friendlytofu/diy-dual-cmos-camera/case/printable/CamBuildLid.stl

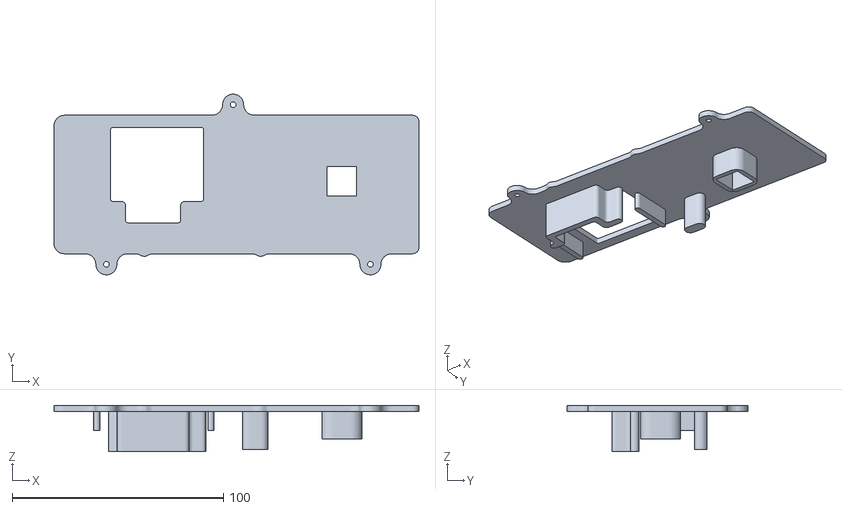
[picture p1: CAD file, 2026-10-28]
case/printable/CamBuildLid.stl
172.8 x 85.5 x 22.0
