friendlytofu/diy-dual-cmos-camera/case/printable/CamBuildFront.stl

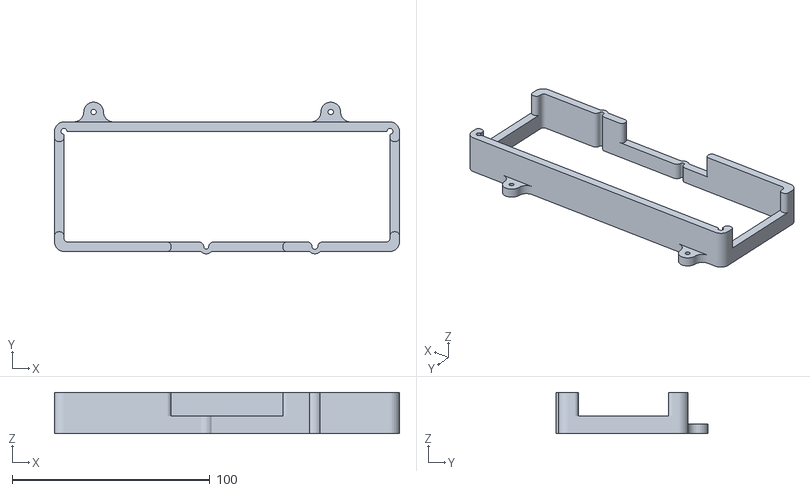
[picture p2: CAD file, 2026-10-28]
case/printable/CamBuildFront.stl
174.6 x 76.7 x 21.0
