friendlytofu/diy-dual-cmos-camera/case/printable/CamBuildCase.stl

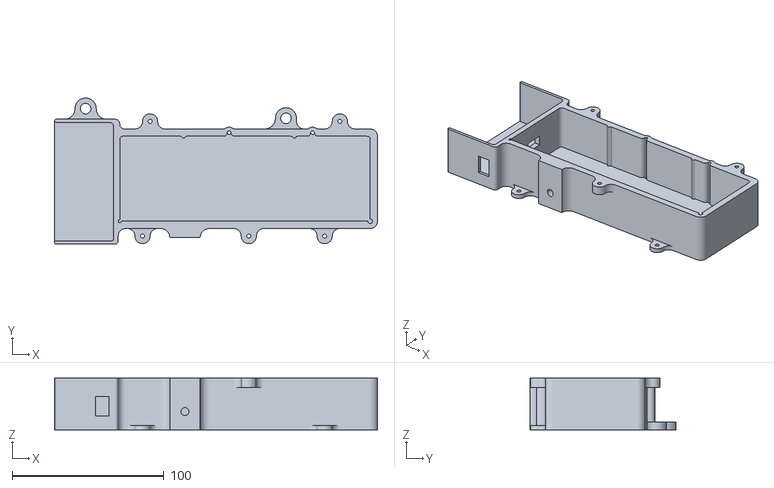
[picture p3: CAD file, 2026-10-28]
case/printable/CamBuildCase.stl
212.8 x 96.2 x 34.0
