friendlytofu/diy-dual-cmos-camera/case/assembly/CamBuild_Assembly_Instructions_Updated.pdf

# CAMERA ENCLOSURE

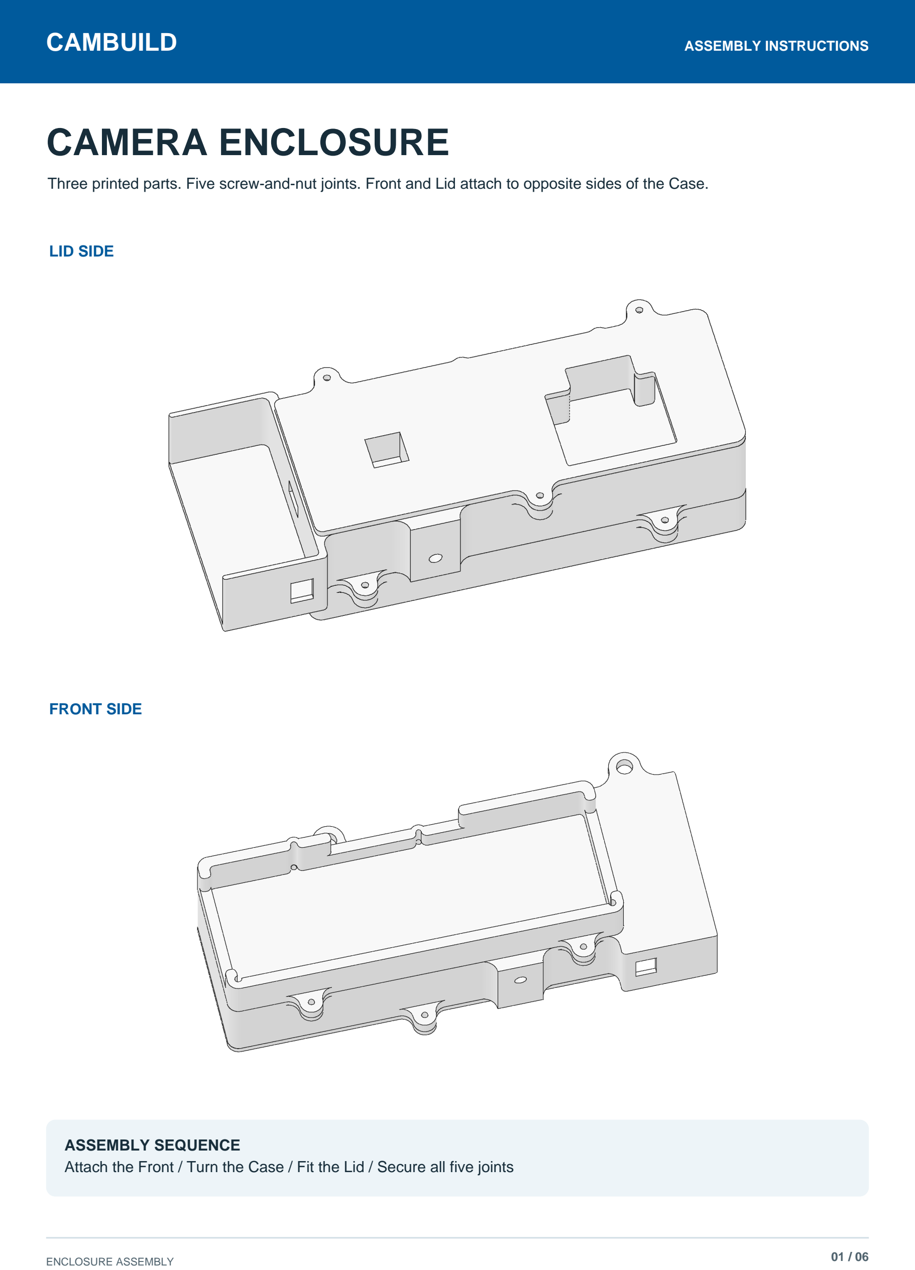
[picture p4: page 1]

CAMBUILD | ASSEMBLY INSTRUCTIONS

Three printed parts. Five screw-and-nut joints. Front and Lid attach to opposite sides of the Case.

ENCLOSURE ASSEMBLY | 01 / 06

LID SIDE

FRONT SIDE

ASSEMBLY SEQUENCE
Attach the Front / Turn the Case / Fit the Lid / Secure all five joints

CAMBUILD | PARTS AND PREPARATION

# CHECK THE PARTS

A = Case body | B = Front frame | C = Lid

A CASE BODY x 1

Case geometry
| 212.8 x 96.2 x 34 mm Main floor: 3 mm Extension floor: 3.4 mm Two lower Front ears Three upper Lid ears Two auxiliary mounting tabs

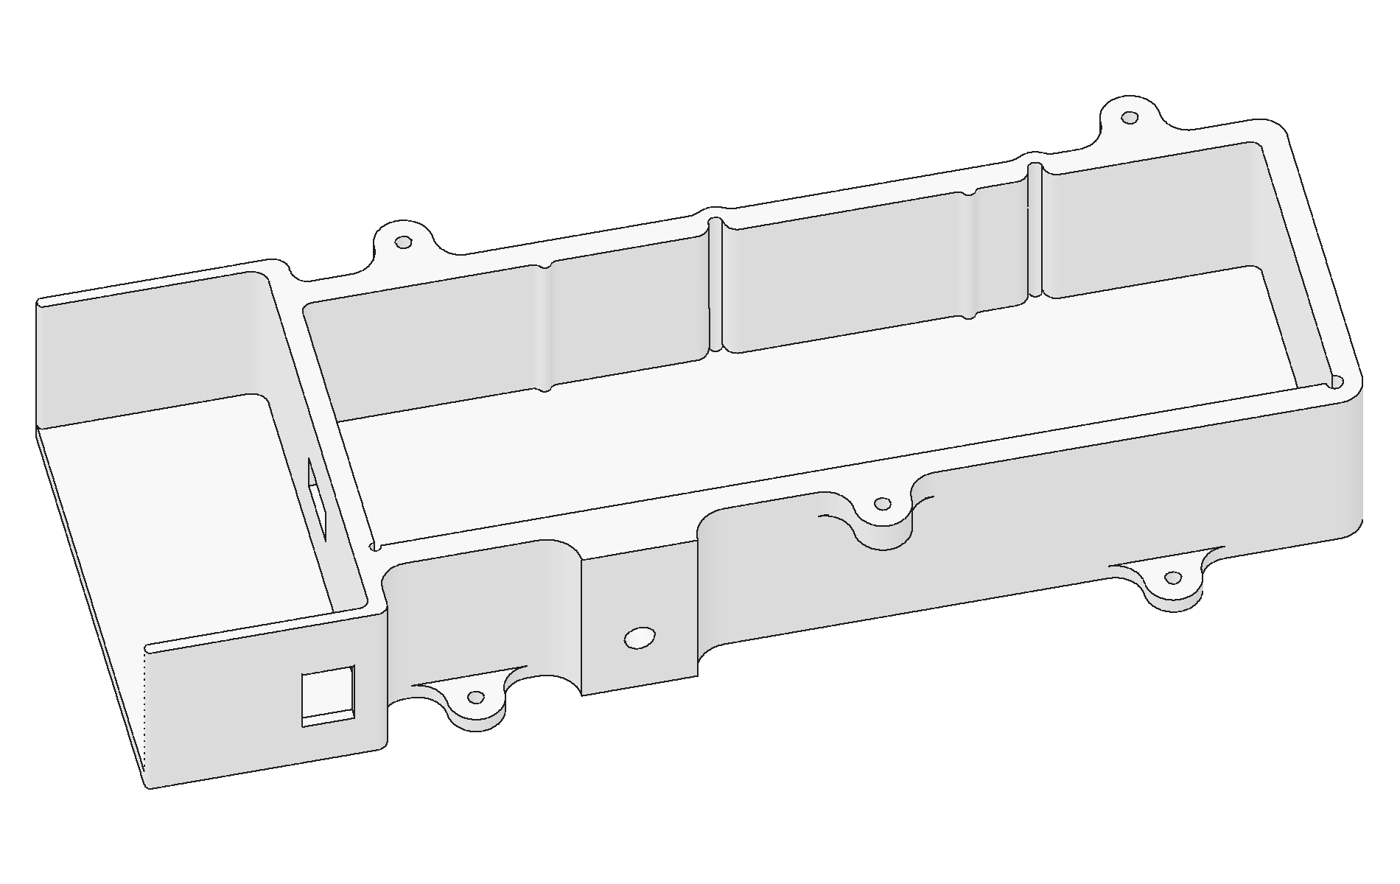
[picture p5: figure]

B FRONT x 1 | C LID x 1

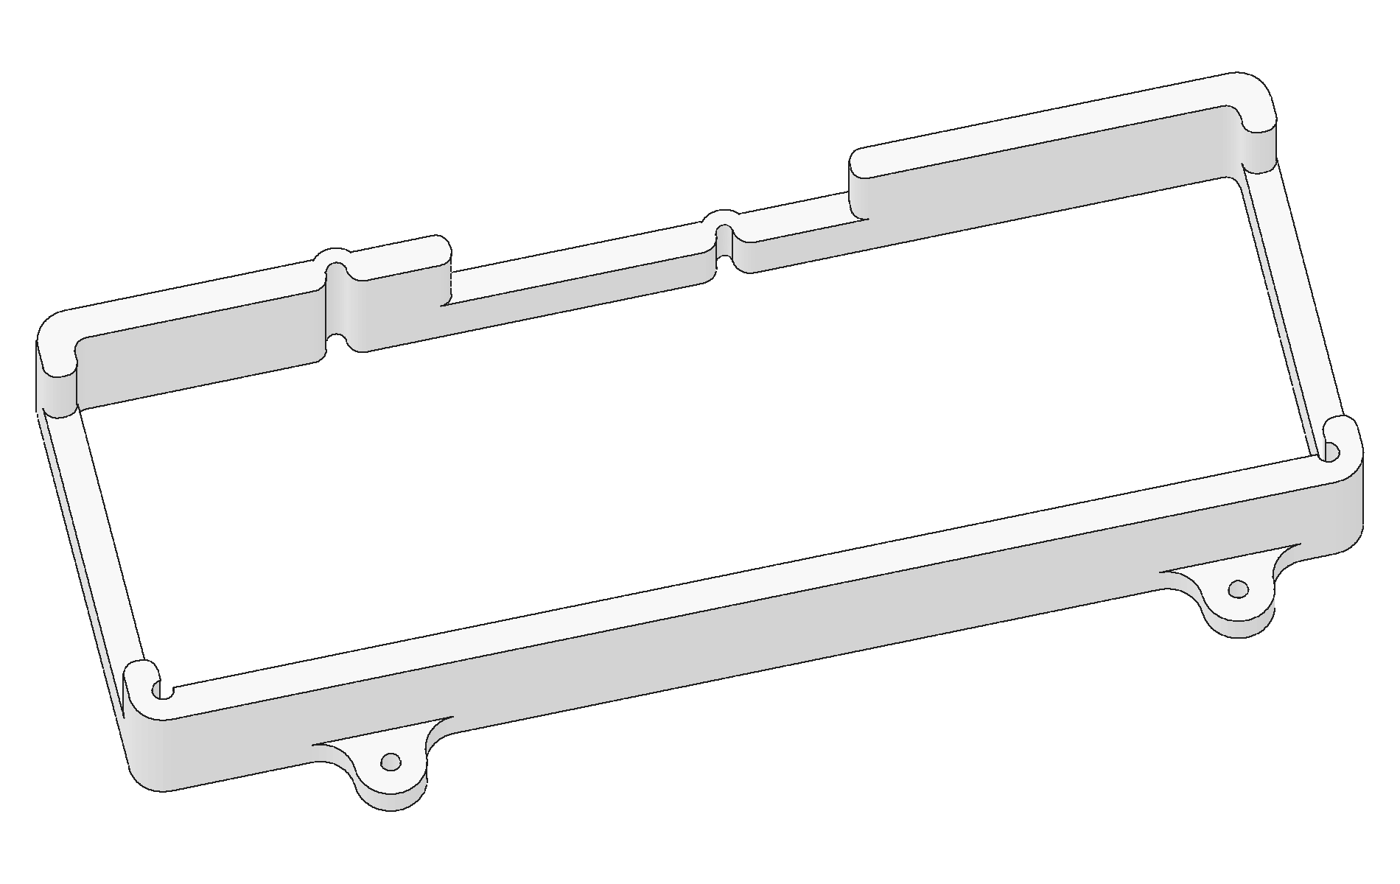
[picture p6: figure]

HARDWARE

M3 screws x 5
M3 nuts x 5

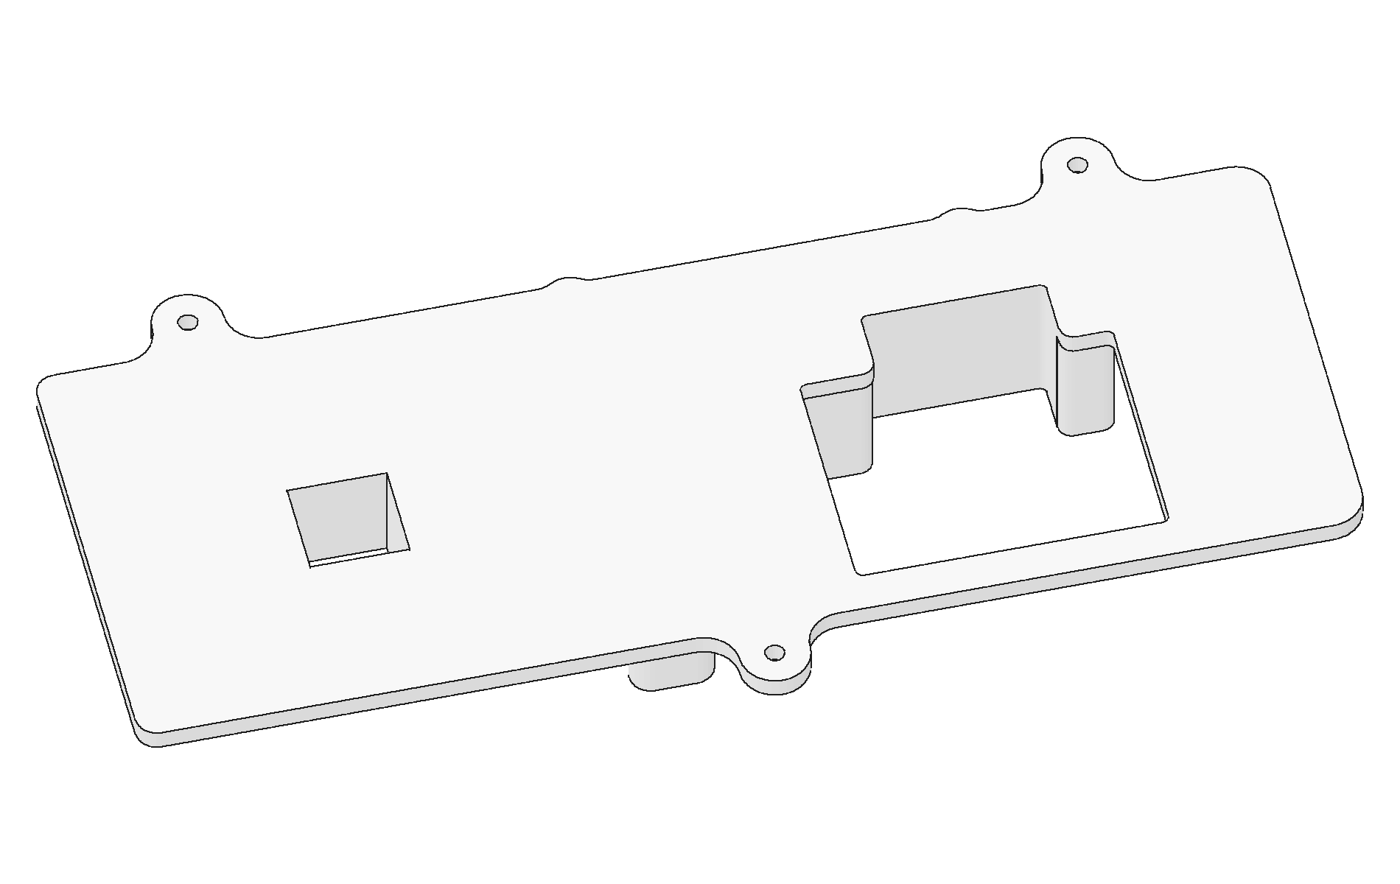
[picture p7: figure]

F1-F2: Front joints, 8 mm plastic stack.
L1-L3: Lid joints, 9 mm plastic stack.
Allow additional screw length for nut engagement.

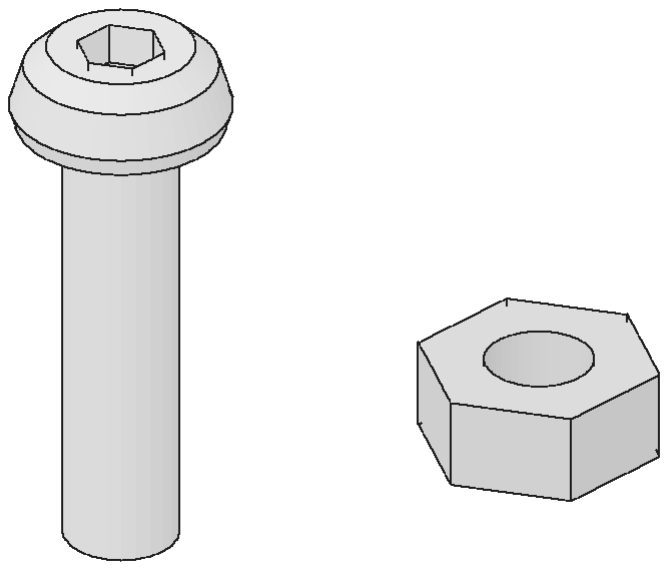
[picture p8: figure]

Remove support material and brim. Deburr the openings and clean the mating surfaces before assembly.

# 1 ATTACH THE FRONT

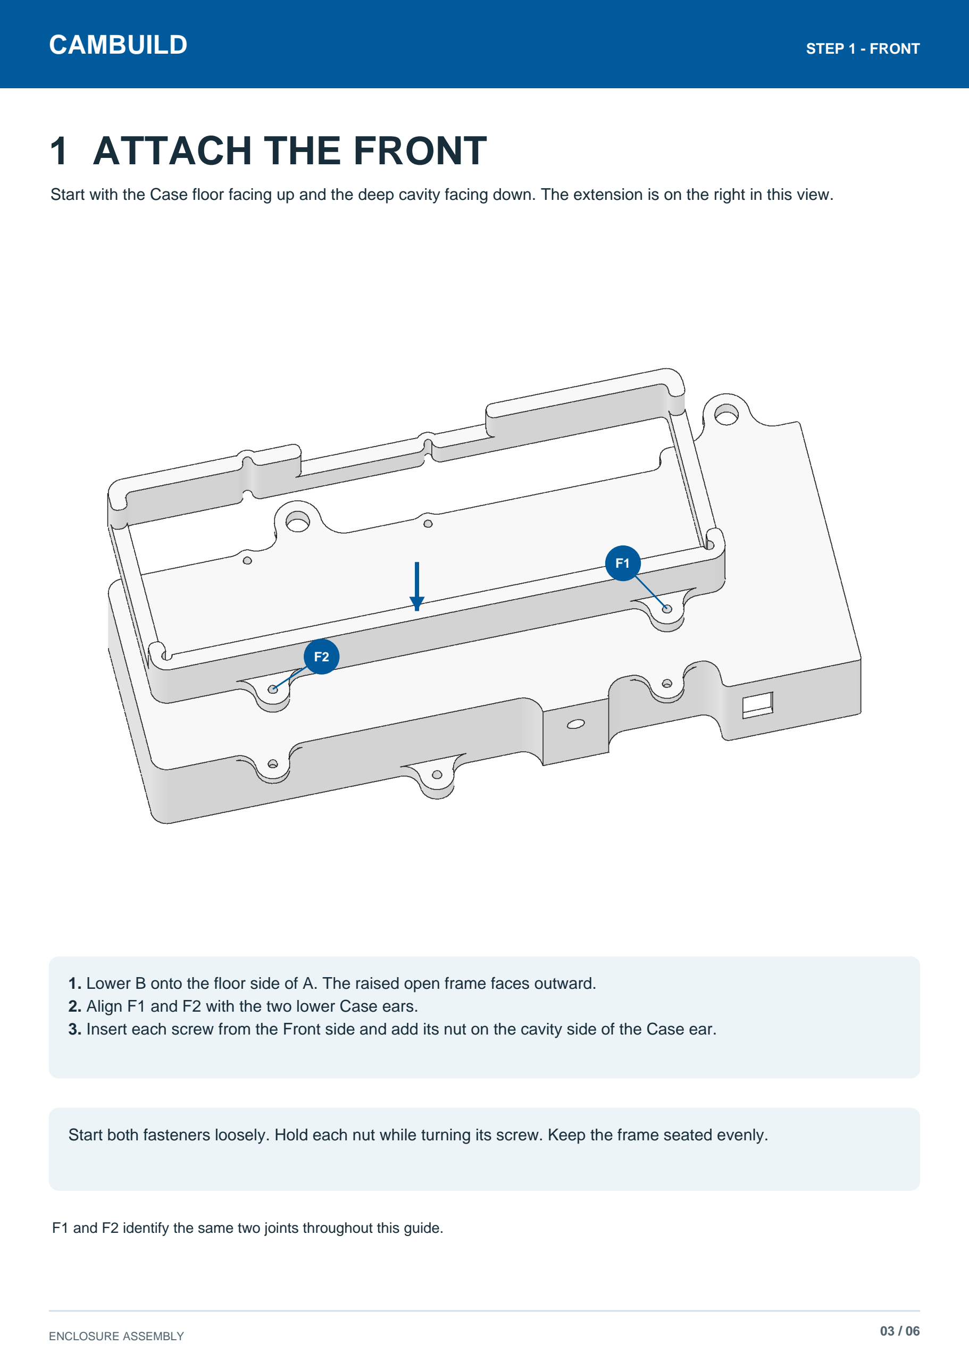
[picture p9: page 3]

CAMBUILD | STEP 1 - FRONT

Start with the Case floor facing up and the deep cavity facing down. The extension is on the right in this view.

F1

F2

1. Lower B onto the floor side of A. The raised open frame faces outward.
2. Align F1 and F2 with the two lower Case ears.
3. Insert each screw from the Front side and add its nut on the cavity side of the Case ear.

Start both fasteners loosely. Hold each nut while turning its screw. Keep the frame seated evenly.

F1 and F2 identify the same two joints throughout this guide.

CAMBUILD | STEP 2 - TURN AND CHECK

# 2 CHECK, THEN TURN

Support both parts while turning the enclosure over. Keep the Front attached loosely.

BEFORE: FLOOR SIDE UP | AFTER: CAVITY SIDE UP

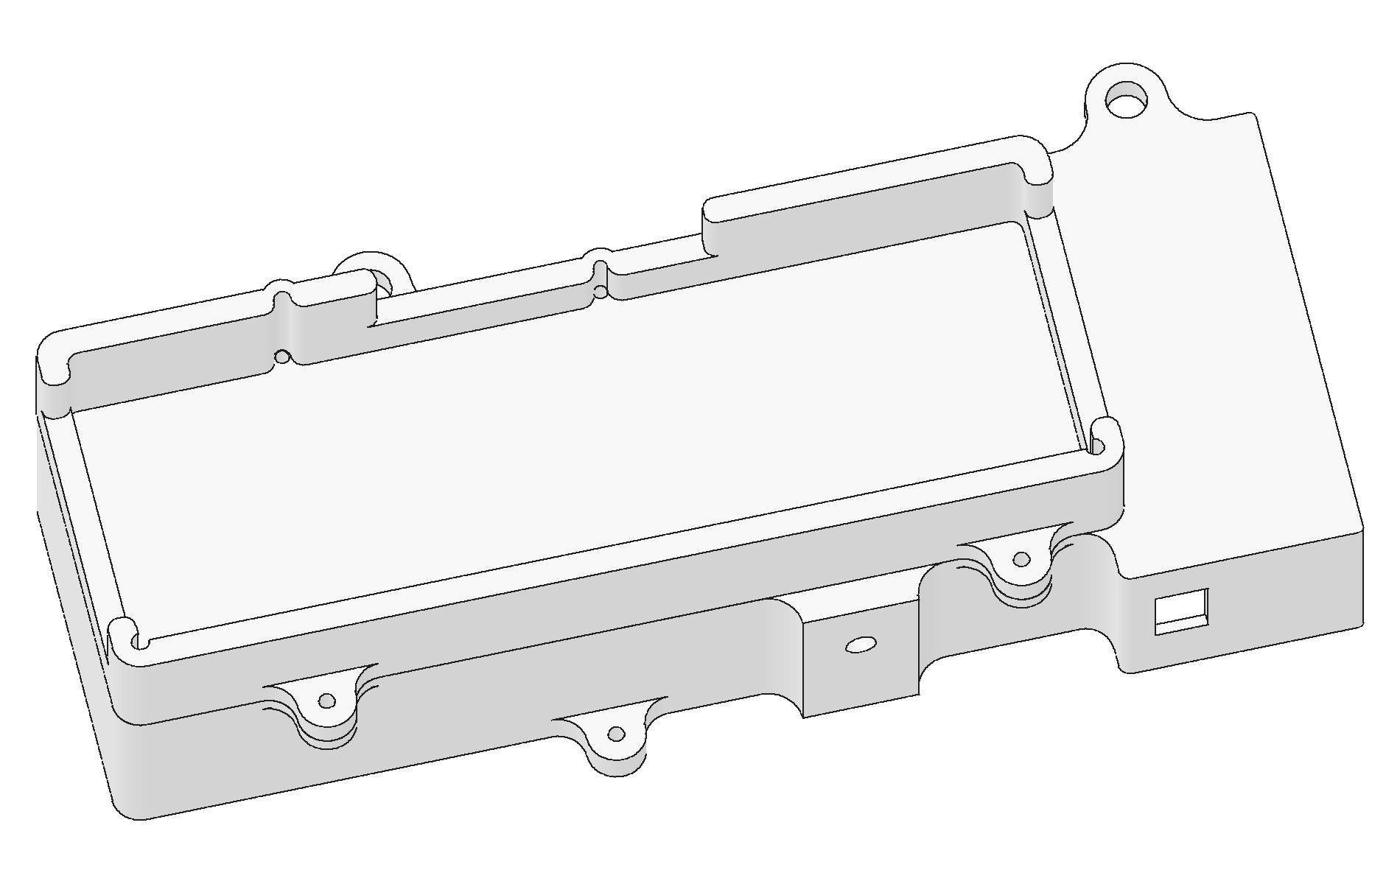
[picture p10: figure]
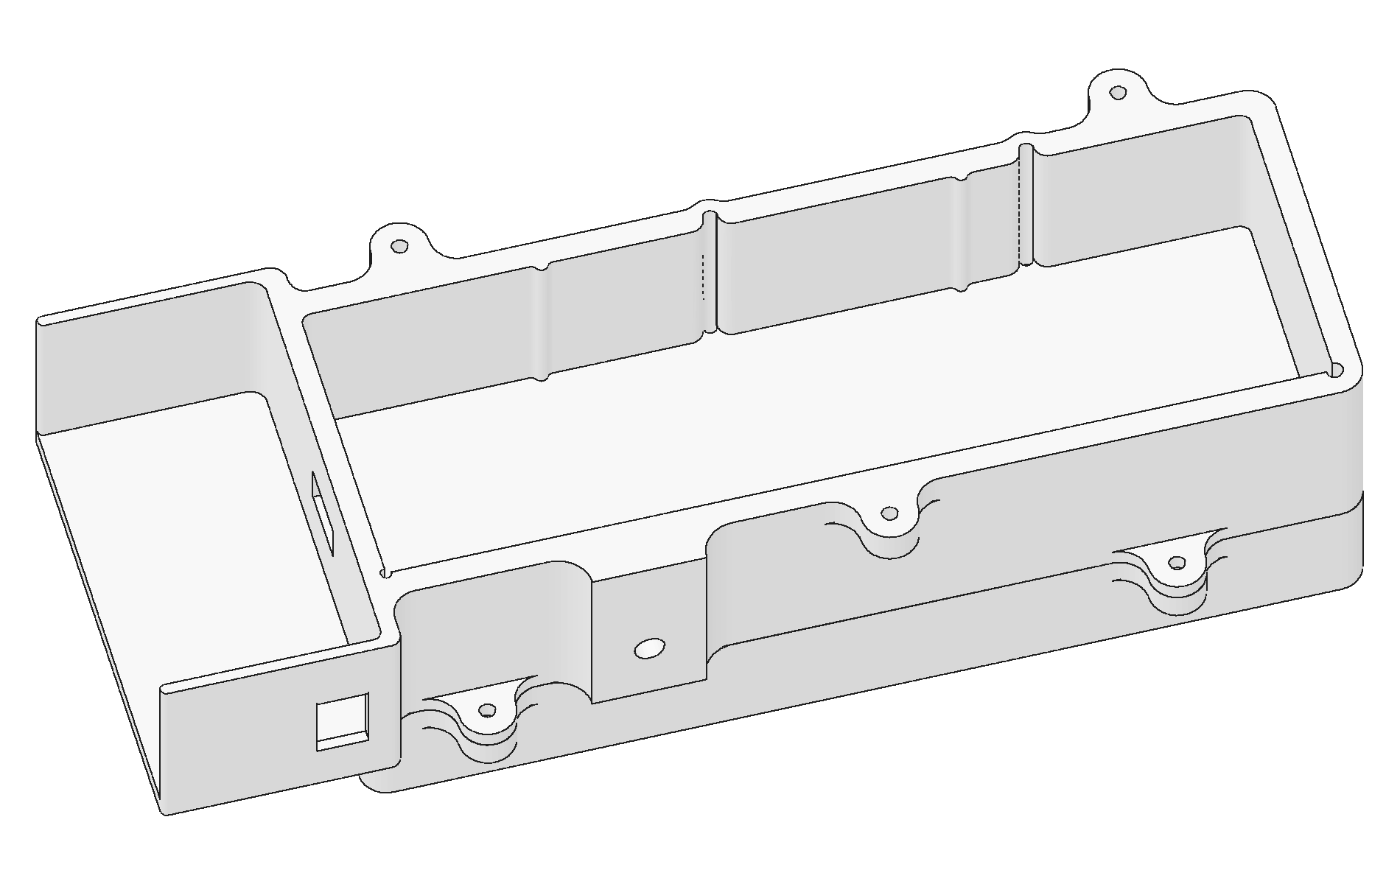
[picture p11: figure]

After turning, the deep Case cavity faces up. Orient the power-bank extension to the left, as shown in the second view. Keep both Front nuts accessible during assembly.

FASTENER STACKS - SECTION PRINCIPLE

FRONT JOINT

Cover: 5 mm
Case ear: 3 mm
Total plastic: 8 mm

Screw head outside; nut on cavity side.

LID JOINT

Cover: 3 mm
Case ear: 6 mm
Total plastic: 9 mm

Screw head outside; nut on cavity side.

Fastener orientation
The screw head sits on the outer cover. The nut seats against the inner face of the Case ear. Hold the nut while turning the screw.

Bring the mating ear faces together and align the screw holes before final tightening.

CAMBUILD | STEP 3 - LID

# 3 ORIENT AND LOWER THE LID

The raised supports on the inside of the Lid face down into the deep Case cavity.

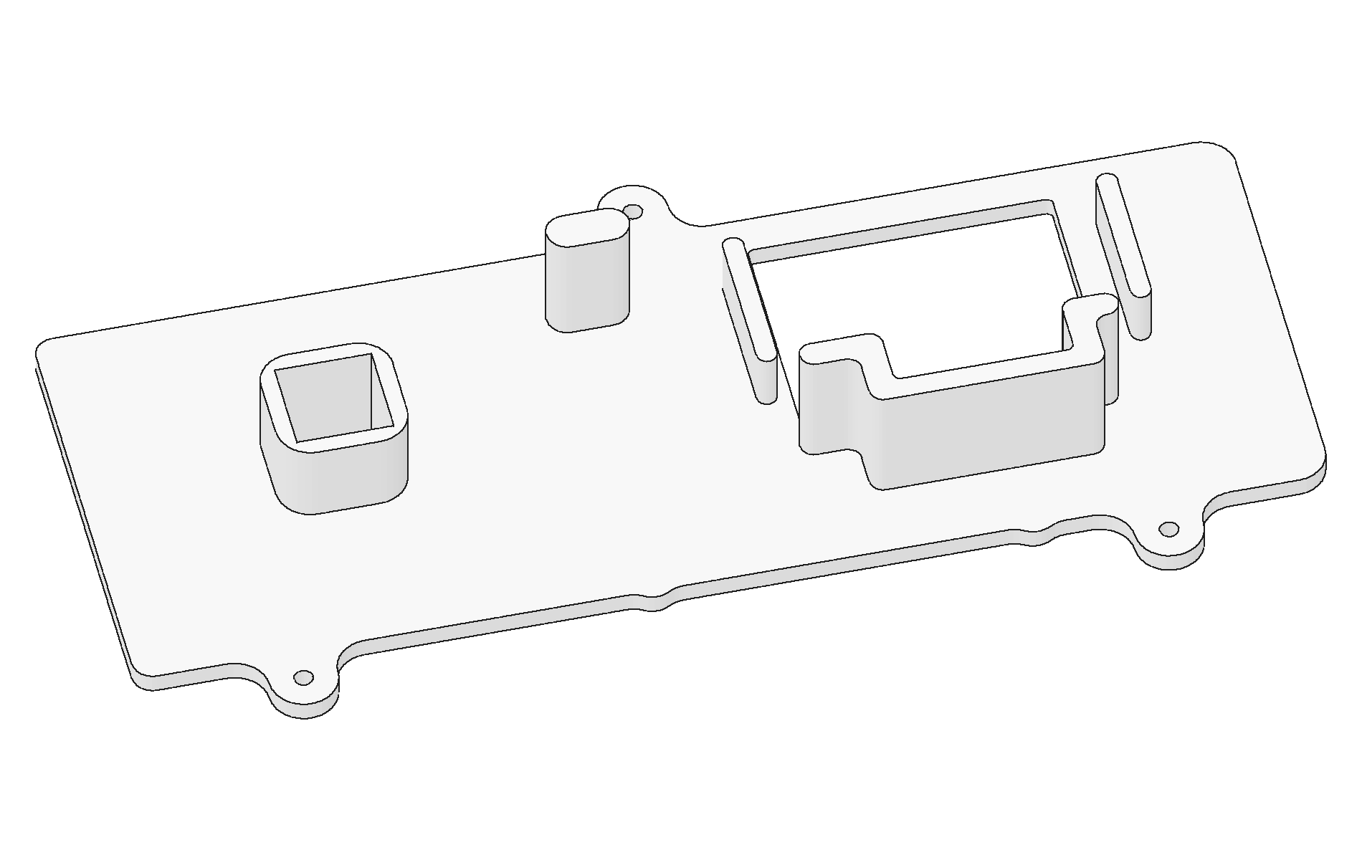
[picture p12: figure]

Match these features
With the extension at the left:
- Small square opening at the left
- Larger stepped opening at the right
- Two Lid ears on the far long side
- One Lid ear on the near long side

The inset shows the inside face.

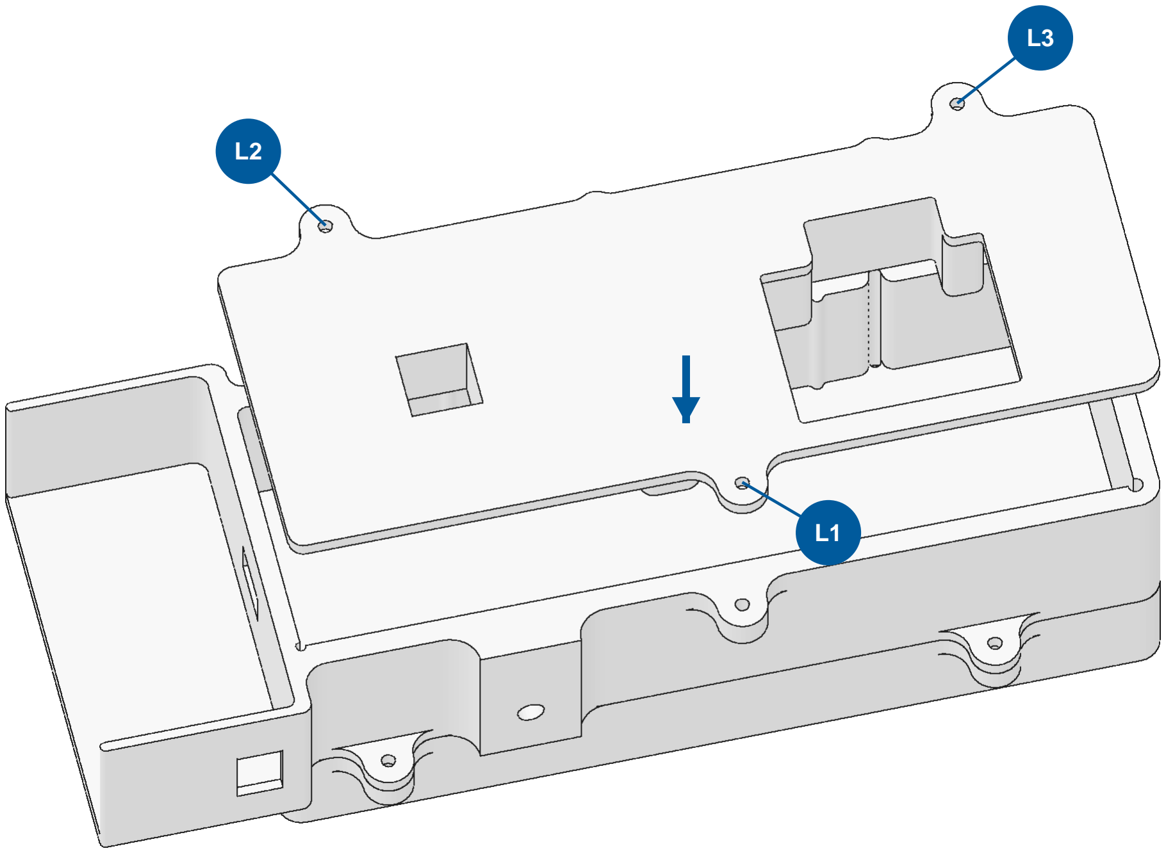
[picture p13: figure]

Lower C straight down without twisting. Its seating face meets the Case rim at 34 mm above the base. Align L1-L3, insert screws from the Lid side and add nuts under the three Case ears. Guide the internal supports into the cavity and start all three joints loosely.

CAMBUILD | STEP 4 - FINISH

# 4 SECURE AND CHECK

Five joints total: two on the Front side and three on the Lid side.

L3

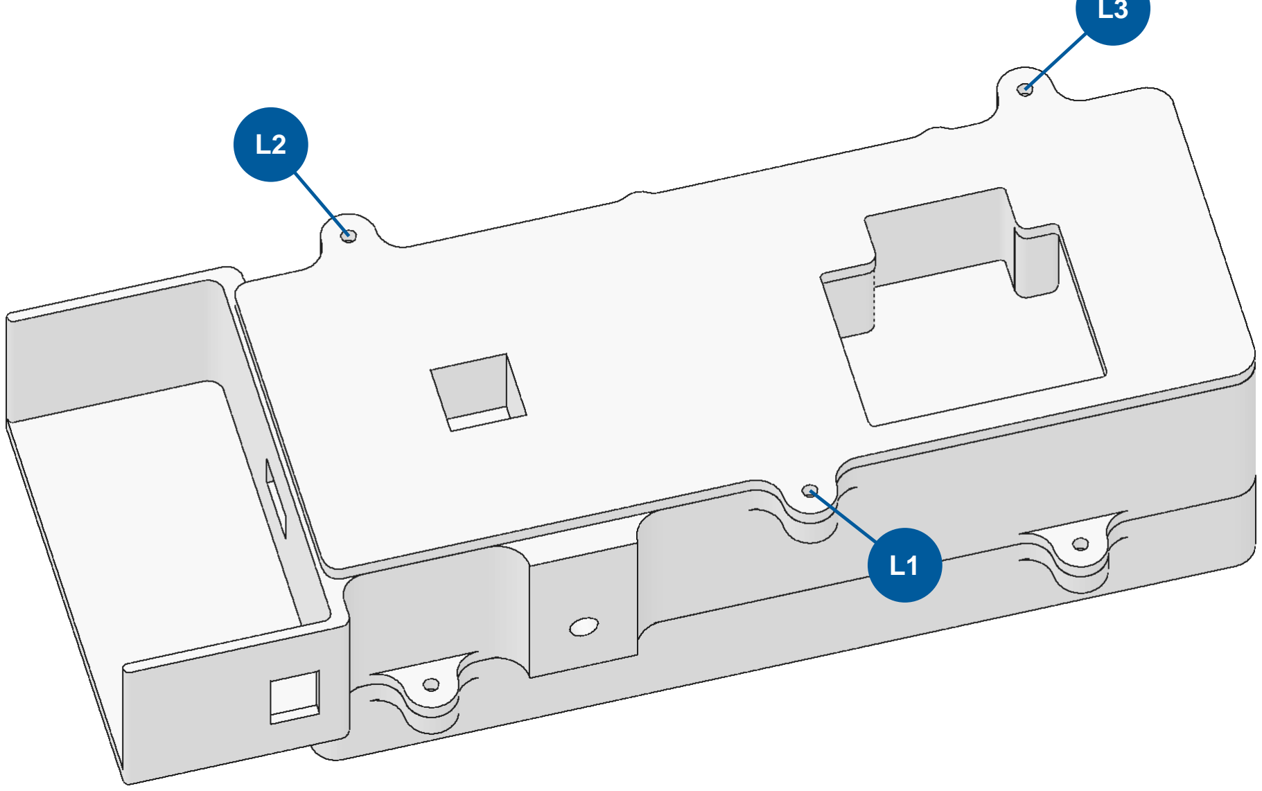
[picture p14: figure]

LID SIDE: L1 + L2 + L3

FRONT SIDE: F1 + F2

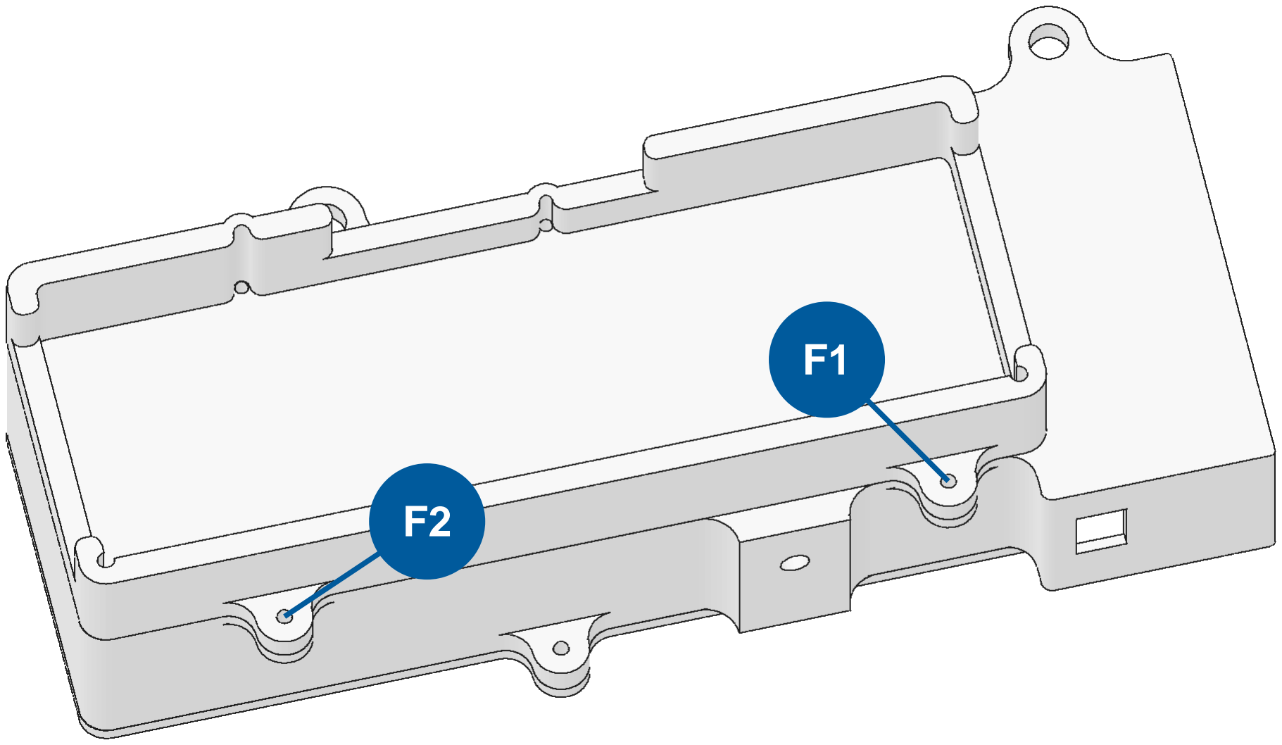
[picture p15: figure]

Tighten in small alternating passes: F1 - L3 - F2 - L2 - L1. Bring each joint to snug contact with the covers seated evenly.

Final inspection
Confirm all five nuts are engaged, both seams are even, and the openings and controls are clear. Check that wiring sits fully inside the enclosure.
