friendlytofu/diy-dual-cmos-camera/firmware/final/u4_controller/camera_web.h

#pragma once
#include <Arduino.h>

const uint8_t CAMERA_WEB_GZIP[] PROGMEM = {
  0x1f, 0x8b, 0x08, 0x00, 0x00, 0x00, 0x00, 0x00, 0x02, 0xff, 0xad, 0x5b, 0x6b, 0x92, 0xdb, 0x46,
  0x92, 0xfe, 0xdf, 0xa7, 0x28, 0x51, 0x5a, 0x03, 0xb0, 0x48, 0xf0, 0xd1, 0xec, 0x17, 0x40, 0x52,
  0x2b, 0xcb, 0x92, 0xd7, 0xb3, 0x92, 0x35, 0xa1, 0x96, 0x62, 0x7e, 0xf4, 0x28, 0xa4, 0x22, 0x50,
  0x68, 0xc2, 0x0d, 0x02, 0x18, 0x00, 0xec, 0x6e, 0x0e, 0x87, 0x11, 0x73, 0x8b, 0xbd, 0xc1, 0x5e,
  0x61, 0xff, 0xcf, 0xdc, 0x64, 0x4e, 0x32, 0x99, 0x59, 0x55, 0x78, 0x91, 0x6c, 0xb7, 0x43, 0x1b,
  0x0e, 0xb7, 0x81, 0x7a, 0x64, 0xe5, 0xf3, 0xcb, 0xcc, 0x02, 0x3d, 0x79, 0xe2, 0x27, 0x5e, 0xb1,
  0x4e, 0x05, 0x5b, 0x14, 0xcb, 0x68, 0x36, 0xc1, 0xbf, 0x2c, 0xe2, 0xf1, 0xf5, 0xb4, 0x23, 0xe2,
  0x0e, 0xbc, 0x0b, 0xee, 0xcf, 0x26, 0x4b, 0x51, 0x70, 0xe6, 0x2d, 0x78, 0x96, 0x8b, 0x62, 0xda,
  0x59, 0x15, 0x41, 0xef, 0xbc, 0xa3, 0x46, 0x63, 0xbe, 0x14, 0xd3, 0xce, 0x6d, 0x28, 0xee, 0xd2,
  0x24, 0x2b, 0x3a, 0xcc, 0x4b, 0xe2, 0x42, 0xc4, 0xb0, 0xea, 0x2e, 0xf4, 0x8b, 0xc5, 0xd4, 0x17,
  0xb7, 0xa1, 0x27, 0x7a, 0xf4, 0xd2, 0x0d, 0xe3, 0xb0, 0x08, 0x79, 0xd4, 0xcb, 0x3d, 0x1e, 0x89,
  0xe9, 0xb0, 0xab, 0x77, 0xf5, 0x82, 0xb0, 0x98, 0x7a, 0xc9, 0xad, 0xc8, 0x9a, 0x54, 0x8b, 0x85,
  0x58, 0x8a, 0x9e, 0x97, 0x44, 0x49, 0x56, 0x23, 0xfc, 0x34, 0x38, 0x09, 0x46, 0xe2, 0x02, 0x96,
  0x16, 0x61, 0x11, 0x89, 0xd9, 0xc7, 0x24, 0x58, 0xbd, 0xe2, 0xcb, 0x49, 0x5f, 0xbe, 0x4e, 0xf2,
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
  0x4d, 0x39, 0x04, 0x47, 0xe6, 0x49, 0x14, 0xfa, 0xac, 0xb2, 0xcb, 0xd6, 0x9e, 0x83, 0x12, 0x7e,
  0xfb, 0xec, 0x6b, 0x9e, 0x3a, 0x43, 0xd0, 0x91, 0x32, 0xac, 0x12, 0xde, 0x2d, 0xc4, 0x7d, 0xd1,
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
};
constexpr size_t CAMERA_WEB_GZIP_SIZE = 4811;
